andresarmento/marvin/rtl/marvin_cpu.v

/**************************************************************************************
 * Marvin CPU is totally based on FemtoRV32 Quark
 * 
 * Changes:
 *  - Memory interface uses mem_valid / mem_ready like picoRV32
 *  - Initial state is FETCH_INSTR 
 *  - Reset signal changed to nrst
 *  - Initial values defined on reset, not in initial block
 *  - RESET_ADDR and ADDR_WITH passed as parameters
 *  - ECALL/EBREAK ignored
 *  - cycles counter removed
 *
 * Bruno Levy, Matthias Koch, 2020-2021
 * André Sarmento, 2025
***************************************************************************************/

module maRVin_cpu #(parameter RESET_ADDR = 32'h0000_0000, parameter ADDR_WIDTH = 24) (
   input 	 clk,
   input 	 nrst,          // set to 0 to reset the processor
   output [31:0] mem_addr,  // address bus
   output [31:0] mem_wdata, // data to be written
   output [3:0]  mem_wmask, // write mask for the 4 bytes of each word
   input [31:0]  mem_rdata, // input lines for both data and instr
   output mem_valid,        // address is valid (for read or write)
   input  mem_ready,        // memory returns ready = 1 when operation completes
   output [31:0] dbg_x1,
   output [31:0] dbg_x2,
   output [31:0] dbg_x15,
   output [3:0] dbg_state
);

    // Test signals
    assign dbg_x1 = registerFile[1];
    assign dbg_x2 = registerFile[2];
    assign dbg_x15 = registerFile[15];
    assign dbg_state = state;

    /***************************************************************************/
    // Instruction decoding.
    /***************************************************************************/

    // Extracts rd,rs1,rs2,funct3,imm and opcode from instruction.
    // Reference: Table page 104 of:
    // https://content.riscv.org/wp-content/uploads/2017/05/riscv-spec-v2.2.pdf

    // The destination register
    wire [4:0] rdId = instr[11:7];

    // The ALU function, decoded in 1-hot form (doing so reduces LUT count)
    // It is used as follows: funct3Is[val] <=> funct3 == val
    (* onehot *)
    wire [7:0] funct3Is = 8'b00000001 << instr[14:12];

    // The five immediate formats, see RiscV reference (link above), Fig. 2.4 p. 12
    wire [31:0] Uimm = {    instr[31],   instr[30:12], {12{1'b0}}};
    wire [31:0] Iimm = {{21{instr[31]}}, instr[30:20]};
    /* verilator lint_off UNUSED */ // MSBs of SBJimms are not used by addr adder.
    wire [31:0] Simm = {{21{instr[31]}}, instr[30:25],instr[11:7]};
    wire [31:0] Bimm = {{20{instr[31]}}, instr[7],instr[30:25],instr[11:8],1'b0};
    wire [31:0] Jimm = {{12{instr[31]}}, instr[19:12],instr[20],instr[30:21],1'b0};
    /* verilator lint_on UNUSED */

    // Base RISC-V (RV32I) has only 10 different instructions !
    wire isLoad    =  (instr[6:2] == 5'b00000); // rd <- mem[rs1+Iimm]
    wire isALUimm  =  (instr[6:2] == 5'b00100); // rd <- rs1 OP Iimm
    wire isStore   =  (instr[6:2] == 5'b01000); // mem[rs1+Simm] <- rs2
    wire isALUreg  =  (instr[6:2] == 5'b01100); // rd <- rs1 OP rs2
    //wire isSYSTEM  =  (instr[6:2] == 5'b11100); // rd <- cycles
    wire isJAL     =  instr[3]; // (instr[6:2] == 5'b11011); // rd <- PC+4; PC<-PC+Jimm
    wire isJALR    =  (instr[6:2] == 5'b11001); // rd <- PC+4; PC<-rs1+Iimm
    wire isLUI     =  (instr[6:2] == 5'b01101); // rd <- Uimm
    wire isAUIPC   =  (instr[6:2] == 5'b00101); // rd <- PC + Uimm
    wire isBranch  =  (instr[6:2] == 5'b11000); // if(rs1 OP rs2) PC<-PC+Bimm

    wire isALU = isALUimm | isALUreg;

    /***************************************************************************/
    // The register file.
    /***************************************************************************/
    reg [31:0] rs1;
    reg [31:0] rs2;
    
    (* no_rw_check *)
    reg [31:0] registerFile[31:0];

    always @(posedge clk) begin
        if (writeBack)
        if (rdId != 0)
            registerFile[rdId] <= writeBackData;
    end

    /***************************************************************************/
    // The ALU. Does operations and tests combinatorially, except shifts.
    /***************************************************************************/

    // First ALU source, always rs1
    wire [31:0] aluIn1 = rs1;

    // Second ALU source, depends on opcode:
    //    ALUreg, Branch:     rs2
    //    ALUimm, Load, JALR: Iimm
    wire [31:0] aluIn2 = isALUreg | isBranch ? rs2 : Iimm;

    reg  [31:0] aluReg;       // The internal register of the ALU, used by shift.
    reg  [4:0]  aluShamt;     // Current shift amount.

    wire aluBusy = |aluShamt; // ALU is busy if shift amount is non-zero.
    wire aluWr;               // ALU write strobe, starts shifting.

    // The adder is used by both arithmetic instructions and JALR.
    wire [31:0] aluPlus = aluIn1 + aluIn2;

    // Use a single 33 bits subtract to do subtraction and all comparisons
    // (trick borrowed from swapforth/J1)
    wire [32:0] aluMinus = {1'b1, ~aluIn2} + {1'b0,aluIn1} + 33'b1;
    wire        LT  = (aluIn1[31] ^ aluIn2[31]) ? aluIn1[31] : aluMinus[32];
    wire        LTU = aluMinus[32];
    wire        EQ  = (aluMinus[31:0] == 0);

    // Notes:
    // - instr[30] is 1 for SUB and 0 for ADD
    // - for SUB, need to test also instr[5] to discriminate ADDI:
    //    (1 for ADD/SUB, 0 for ADDI, and Iimm used by ADDI overlaps bit 30 !)
    // - instr[30] is 1 for SRA (do sign extension) and 0 for SRL

    wire [31:0] aluOut =
        (funct3Is[0]  ? instr[30] & instr[5] ? aluMinus[31:0] : aluPlus : 32'b0) |
        (funct3Is[2]  ? {31'b0, LT}                                     : 32'b0) |   //
        (funct3Is[3]  ? {31'b0, LTU}                                    : 32'b0) |   //
        (funct3Is[4]  ? aluIn1 ^ aluIn2                                 : 32'b0) |   //
        (funct3Is[6]  ? aluIn1 | aluIn2                                 : 32'b0) |
        (funct3Is[7]  ? aluIn1 & aluIn2                                 : 32'b0) |
        (funct3IsShift ? aluReg                                         : 32'b0) ;

    wire funct3IsShift = funct3Is[1] | funct3Is[5];

    always @(posedge clk) begin
        if(aluWr) begin
            if (funct3IsShift) begin  // SLL, SRA, SRL
            aluReg <= aluIn1;
            aluShamt <= aluIn2[4:0];
        end
        end

        `ifdef NRV_TWOLEVEL_SHIFTER
            else if(|aluShamt[4:2]) begin // Shift by 4
                aluShamt <= aluShamt - 4;
            aluReg <= funct3Is[1] ? aluReg << 4 :
                {{4{instr[30] & aluReg[31]}}, aluReg[31:4]};
            end  else
        `endif
        // Compact form of:
        // funct3=001              -> SLL  (aluReg <= aluReg << 1)
        // funct3=101 &  instr[30] -> SRA  (aluReg <= {aluReg[31], aluReg[31:1]})
        // funct3=101 & !instr[30] -> SRL  (aluReg <= {1'b0,       aluReg[31:1]})

        if (|aluShamt) begin
            aluShamt <= aluShamt - 1;
            aluReg <= funct3Is[1] ? aluReg << 1 :    // SLL
            {instr[30] & aluReg[31], aluReg[31:1]};  // SRA,SRL
        end
    end

    /***************************************************************************/
    // The predicate for conditional branches.
    /***************************************************************************/
    wire predicate =
            funct3Is[0] &  EQ  | // BEQ
            funct3Is[1] & !EQ  | // BNE
            funct3Is[4] &  LT  | // BLT
            funct3Is[5] & !LT  | // BGE
            funct3Is[6] &  LTU | // BLTU
            funct3Is[7] & !LTU ; // BGEU

    /***************************************************************************/
    // Program counter and branch target computation.
    /***************************************************************************/

    reg  [ADDR_WIDTH-1:0] PC; // The program counter.
    reg  [31:2] instr;        // Latched instruction. Note that bits 0 and 1 are
                                // ignored (not used in RV32I base instr set).

    wire [ADDR_WIDTH-1:0] PCplus4 = PC + 4;

    // An adder used to compute branch address, JAL address and AUIPC.
    // branch->PC+Bimm    AUIPC->PC+Uimm    JAL->PC+Jimm
    // Equivalent to PCplusImm = PC + (isJAL ? Jimm : isAUIPC ? Uimm : Bimm)
    wire [ADDR_WIDTH-1:0] PCplusImm = PC + ( instr[3] ? Jimm[ADDR_WIDTH-1:0] :
                            instr[4] ? Uimm[ADDR_WIDTH-1:0] :
                                    Bimm[ADDR_WIDTH-1:0] );

    // A separate adder to compute the destination of load/store.
    // testing instr[5] is equivalent to testing isStore in this context.
    wire [ADDR_WIDTH-1:0] loadstore_addr = rs1[ADDR_WIDTH-1:0] +
            (instr[5] ? Simm[ADDR_WIDTH-1:0] : Iimm[ADDR_WIDTH-1:0]);

    /* verilator lint_off WIDTH */
    // internal address registers and cycles counter may have less than 
    // 32 bits, so we deactivate width test for mem_addr and writeBackData

    assign mem_addr = state[WAIT_INSTR_bit] | state[FETCH_INSTR_bit] ?
                PC : loadstore_addr ;

    /***************************************************************************/
    // The value written back to the register file.
    /***************************************************************************/

    wire [31:0] writeBackData  =
        (isLUI               ? Uimm       : 32'b0) |  // LUI
        (isALU               ? aluOut     : 32'b0) |  // ALUreg, ALUimm
        (isAUIPC             ? PCplusImm  : 32'b0) |  // AUIPC
        (isJALR   | isJAL    ? PCplus4    : 32'b0) |  // JAL, JALR
        (isLoad              ? LOAD_data  : 32'b0) ;  // Load
         //(isSYSTEM            ? cycles     : 32'b0) |  // SYSTEM     

    /***************************************************************************/
    // LOAD/STORE
    /***************************************************************************/
    // All memory accesses are aligned on 32 bits boundary. For this
    // reason, we need some circuitry that does unaligned halfword
    // and byte load/store, based on:
    // - funct3[1:0]:  00->byte 01->halfword 10->word
    // - mem_addr[1:0]: indicates which byte/halfword is accessed

    wire mem_byteAccess     = instr[13:12] == 2'b00; // funct3[1:0] == 2'b00;
    wire mem_halfwordAccess = instr[13:12] == 2'b01; // funct3[1:0] == 2'b01;

    // LOAD, in addition to funct3[1:0], LOAD depends on:
    // - funct3[2] (instr[14]): 0->do sign expansion   1->no sign expansion

    wire LOAD_sign =
        !instr[14] & (mem_byteAccess ? LOAD_byte[7] : LOAD_halfword[15]);

    wire [31:0] LOAD_data =
        mem_byteAccess ? {{24{LOAD_sign}},     LOAD_byte} :
        mem_halfwordAccess ? {{16{LOAD_sign}}, LOAD_halfword} :
        mem_rdata ;

    wire [15:0] LOAD_halfword =
        loadstore_addr[1] ? mem_rdata[31:16] : mem_rdata[15:0];

    wire  [7:0] LOAD_byte =
        loadstore_addr[0] ? LOAD_halfword[15:8] : LOAD_halfword[7:0];

    // STORE
    assign mem_wdata[ 7: 0] = rs2[7:0];
    assign mem_wdata[15: 8] = loadstore_addr[0] ? rs2[7:0]  : rs2[15: 8];
    assign mem_wdata[23:16] = loadstore_addr[1] ? rs2[7:0]  : rs2[23:16];
    assign mem_wdata[31:24] = loadstore_addr[0] ? rs2[7:0]  :
                              loadstore_addr[1] ? rs2[15:8] : rs2[31:24];

    // The memory write mask:
    //    1111                     if writing a word
    //    0011 or 1100             if writing a halfword
    //                                (depending on loadstore_addr[1])
    //    0001, 0010, 0100 or 1000 if writing a byte
    //                                (depending on loadstore_addr[1:0])

    wire [3:0] STORE_wmask =
            mem_byteAccess ?
                    (loadstore_addr[1] ?
                    (loadstore_addr[0] ? 4'b1000 : 4'b0100) :
                    (loadstore_addr[0] ? 4'b0010 : 4'b0001)) :
            mem_halfwordAccess ?
                    (loadstore_addr[1] ? 4'b1100 : 4'b0011) :
                4'b1111;

    /*************************************************************************/
    // And, last but not least, the state machine.
    /*************************************************************************/

    localparam FETCH_INSTR_bit     = 0;
    localparam WAIT_INSTR_bit      = 1;
    localparam EXECUTE_bit         = 2;
    localparam WAIT_ALU_OR_MEM_bit = 3;
    localparam NB_STATES           = 4;

    localparam FETCH_INSTR     = 1 << FETCH_INSTR_bit;
    localparam WAIT_INSTR      = 1 << WAIT_INSTR_bit;
    localparam EXECUTE         = 1 << EXECUTE_bit;
    localparam WAIT_ALU_OR_MEM = 1 << WAIT_ALU_OR_MEM_bit;

    (* onehot *)
    reg [NB_STATES-1:0] state;

    // The signals (internal and external) that are determined
    // combinatorially from state and other signals.

    // register write-back enable.
    wire writeBack = ~(isBranch | isStore ) & (state[EXECUTE_bit] | state[WAIT_ALU_OR_MEM_bit]);

    // The memory-valid signal.
    assign mem_valid = !mem_ready & (( (state[EXECUTE_bit] | state[WAIT_ALU_OR_MEM_bit]) & (isLoad | isStore) ) | ( nrst & (state[WAIT_INSTR_bit] | state[FETCH_INSTR_bit] )));

    // The mask for memory-write.
    assign mem_wmask = {4{state[EXECUTE_bit] & isStore}} & STORE_wmask;

    // aluWr starts computation (shifts) in the ALU.
    assign aluWr = state[EXECUTE_bit] & isALU;

    wire jumpToPCplusImm = isJAL | (isBranch & predicate);

    wire needToWait = isLoad | isStore | isALU & funct3IsShift;

    always @(posedge clk) begin
        if(!nrst) begin
            state <= FETCH_INSTR;
            PC <= RESET_ADDR[ADDR_WIDTH-1:0];
            aluShamt <= 0;
            registerFile[0] <= 0;
        end else

        // See note [1] at the end of this file.
        (* parallel_case *)
        case(1'b1)

            state[WAIT_INSTR_bit]: begin
                if (mem_ready) begin // may be high when executing from SPI flash
                    rs1 <= registerFile[mem_rdata[19:15]];
                    rs2 <= registerFile[mem_rdata[24:20]];
                    instr <= mem_rdata[31:2]; // Bits 0 and 1 are ignored (see
                    state <= EXECUTE;         // also the declaration of instr).
                end
            end

            state[EXECUTE_bit]: begin
                PC <= isJALR ? {aluPlus[ADDR_WIDTH-1:1],1'b0} :
                        jumpToPCplusImm ? PCplusImm :
                        PCplus4;
                state <= needToWait ? WAIT_ALU_OR_MEM : FETCH_INSTR;
            end

            state[WAIT_ALU_OR_MEM_bit]: begin
                if (!aluBusy & (mem_ready | !(isLoad | isStore))) state <= FETCH_INSTR;
            end

            default: begin // FETCH_INSTR
                state <= WAIT_INSTR;
            end

        endcase
    end
endmodule
