andresarmento/marvin/(commit log)

2026-07-05 New gpio hardware e driver, input and output
2026-07-06 Interface Serial UART (TX)
2026-07-07 Interface UART (RX)
